Chaunchoy/NovaTech/others/3D Printed Parts/PCB_Base_Plate .jpg

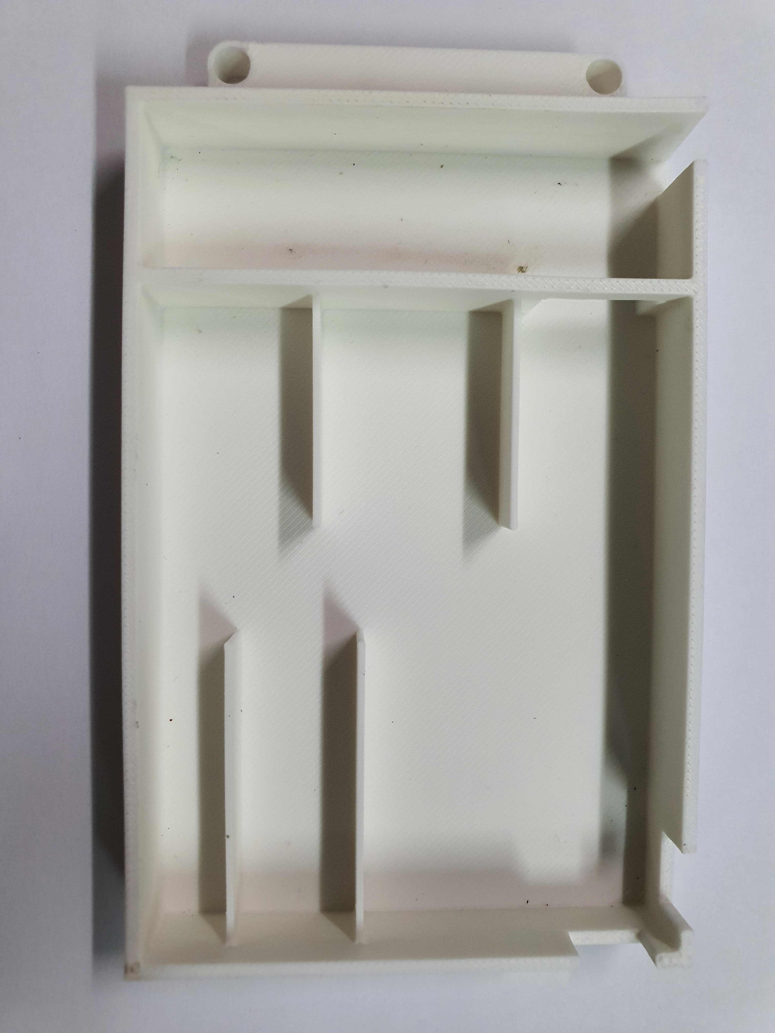
others/3D Printed Parts/PCB_Base_Plate .jpg
