Chaunchoy/NovaTech/others/3D Printed Parts/MG310_Adapter.jpg

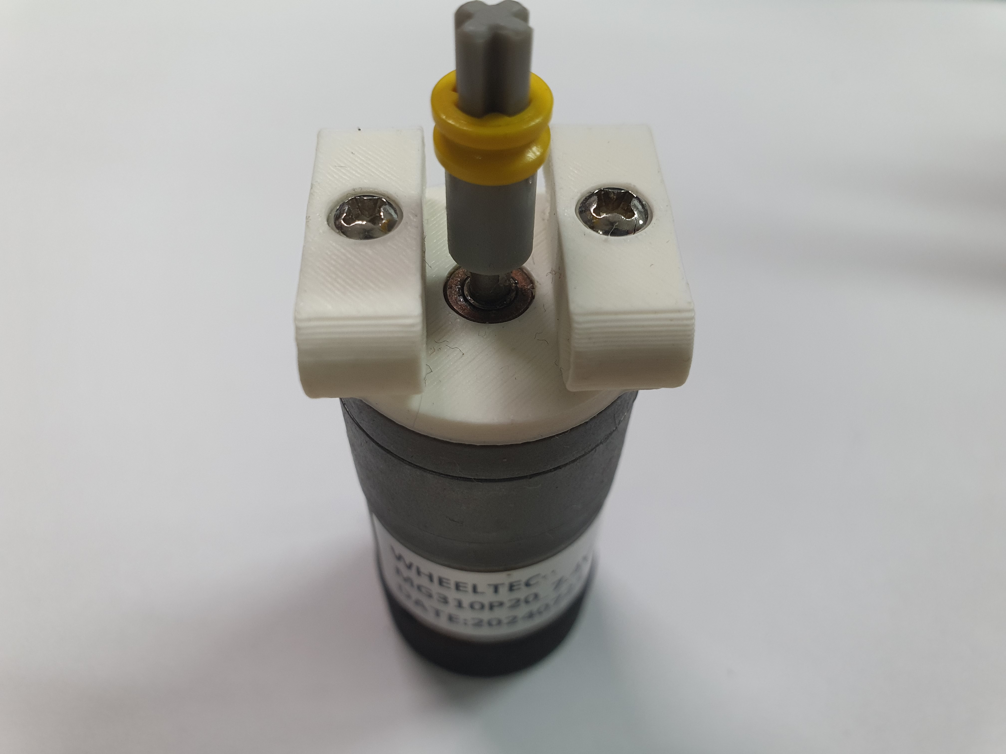
others/3D Printed Parts/MG310_Adapter.jpg
