Chaunchoy/NovaTech/others/README.md

# Others
This directory contains all photos of the components used for the vehicle:

* `3D Printed Parts` The photos of the 3D parts used for the adaptability to vehicle.
* `Control Panel` The photos of the electrical components used for the vehicle.
* `Gear System` The photos of the gear systems which is steering and the main gear system.
* `Motors` The photos of the motor used for the movement of the vehicle.
* `Sensors` The photos of the sensors used in the vehicle.
