Chaunchoy/NovaTech/models/README.md

# Models

This directory contains all the models used for our vehicle and its insturctions to build the vehicle. Since our robot is made out of LEGO technic pieces, we are going to be 3d printing mounts and adapters for the sensors. 
* `BOM_NovaTech` The record of all the components, materials and parts used in the construction of the self-driving car.
* `Building_Instructions_NovaTech` The building instructions for the self driving car.
* `LLD_MODEL_FEC_2025_vers_2` List of all the components, materials and parts used in Microsoft Excel

Below is a table of our 3D-printed parts and what they are used for:

| File Name | Description | Image | 
| --- | --- | --- |
| MG310 Lego Adapter.stl | Provides a strong and secure joint between LEGO® cross-axles/holes and MG310P20 7.4V L motor, making hybrid builds more easy to attach. |  |
| PCB Base Plate.stl | Acts as the main structural plate where components such as main panels , sensors and motors can be fixed in a place. It also strong yet thin, providing a stable chassis without adding too much weight. |  |
| TCS Adapter.stl | It acts as a connector between LEGO® Technic parts and non-LEGO® components (TCS3472 Colour Sensor) |  |
| VL5130.stl | Holds the VL53 sensor breakout board firmly without stress on the pins. They also works as case shields for the VL53LOX ToF Sensors from shocks or misalignment. |  |
