Chaunchoy/NovaTech/video/NovaTech Documentation Video.pdf

Scan the QR Code to see our team documentation video:

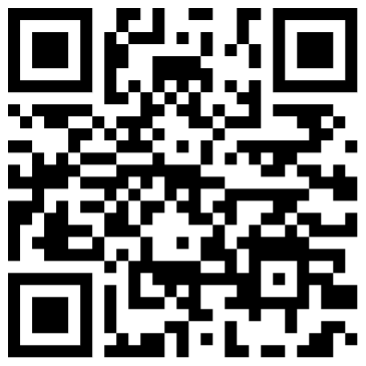
[picture p3: figure]
