Chaunchoy/NovaTech/others/Control Panel/ESP32-S3-DevKitC-1.jpg

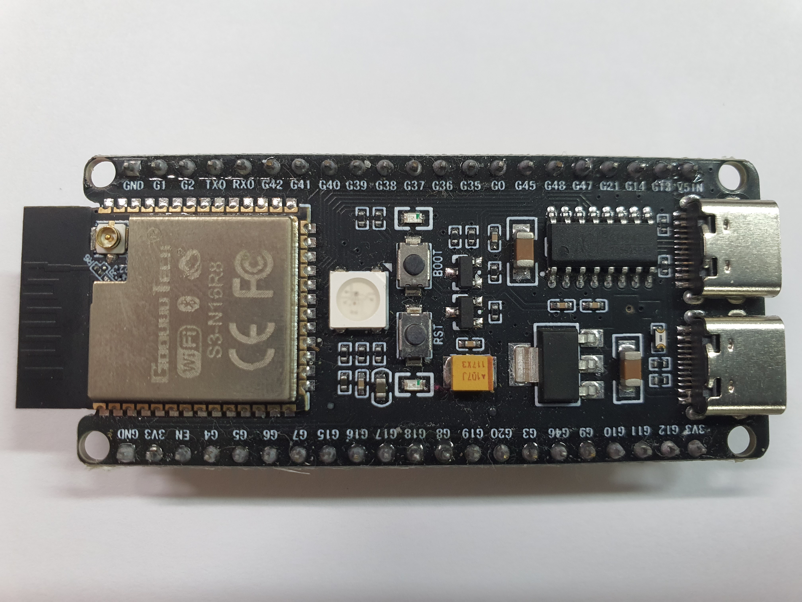
others/Control Panel/ESP32-S3-DevKitC-1.jpg
