Chaunchoy/NovaTech/others/Control Panel/GY-BNO08X Gyro.jpg

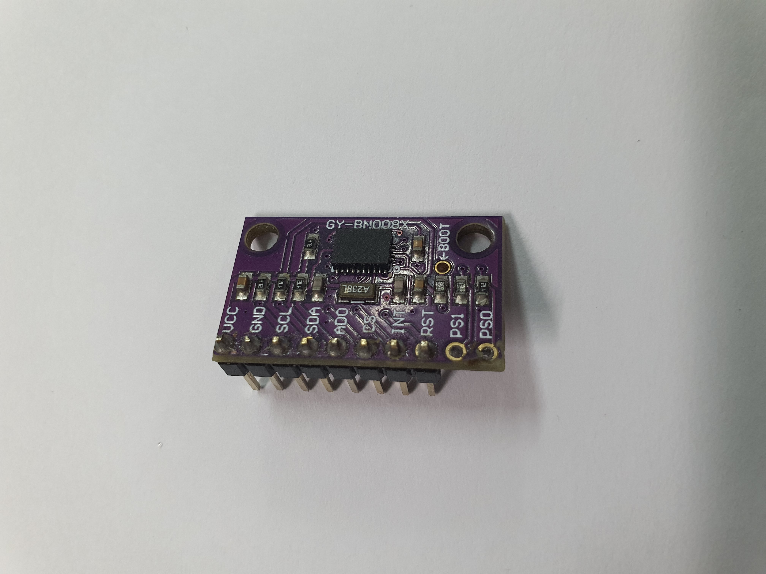
others/Control Panel/GY-BNO08X Gyro.jpg
