Chaunchoy/NovaTech/others/Control Panel/MH-FMD Active Buzzer.jpg

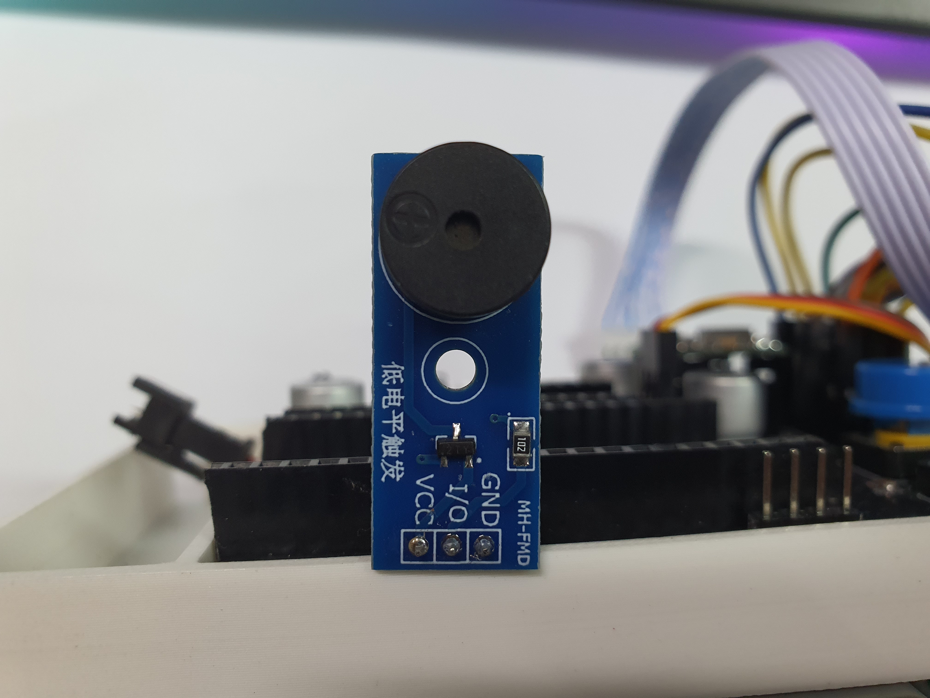
others/Control Panel/MH-FMD Active Buzzer.jpg
