Chaunchoy/NovaTech/others/Control Panel/Mini MP1584EN DC-DC Buck Converter.jpg

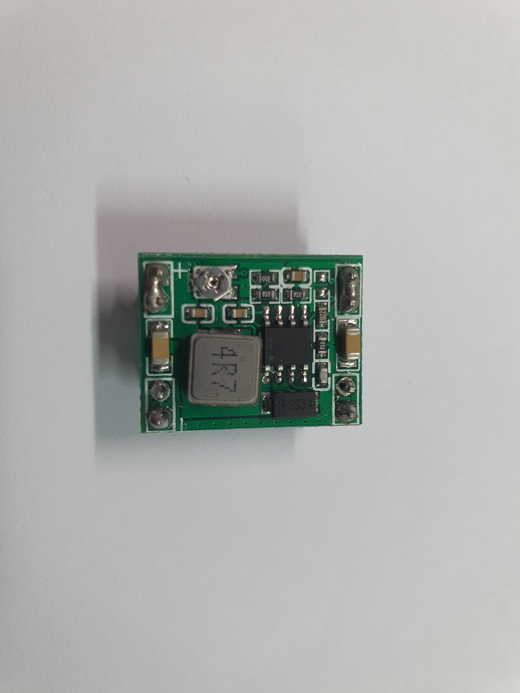
others/Control Panel/Mini MP1584EN DC-DC Buck Converter.jpg
