Chaunchoy/NovaTech/others/Control Panel/PCB Mounted Circuit Button.jpg

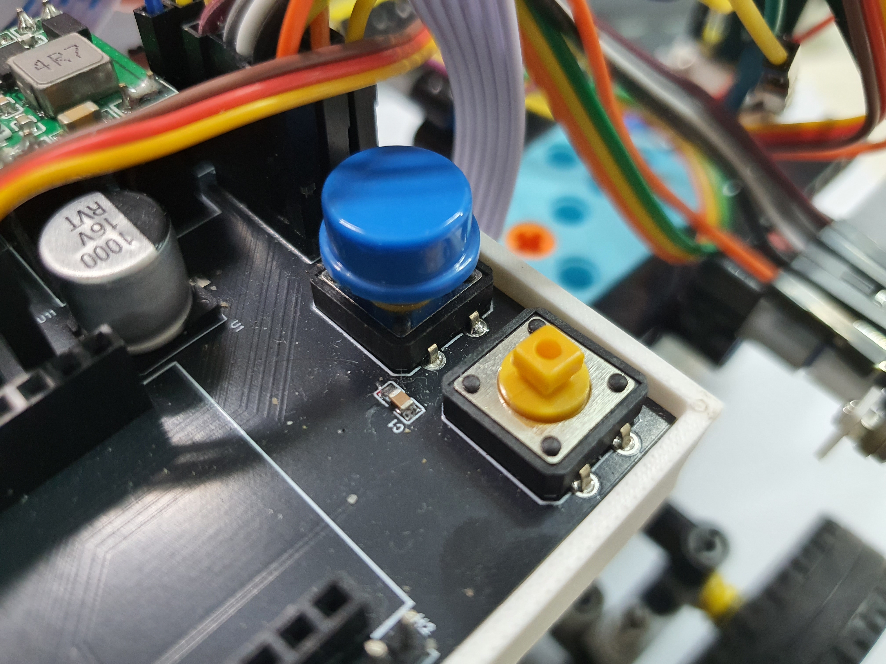
others/Control Panel/PCB Mounted Circuit Button.jpg
