Chaunchoy/NovaTech/others/Control Panel/Resistor.jpg

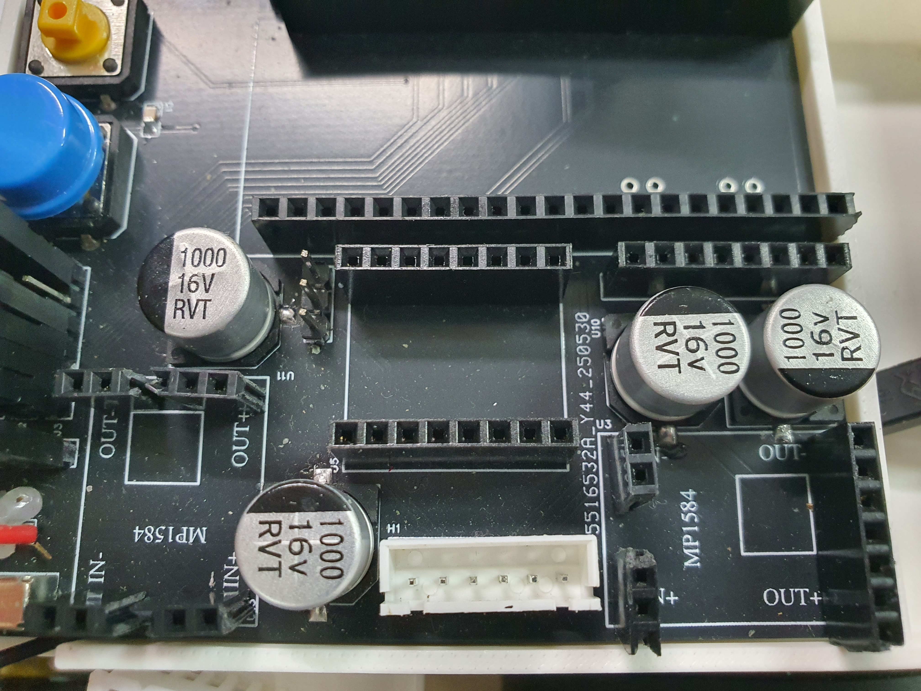
others/Control Panel/Resistor.jpg
