Chaunchoy/NovaTech/others/Gear System/AckermannSteeringSystem(Left).jpg

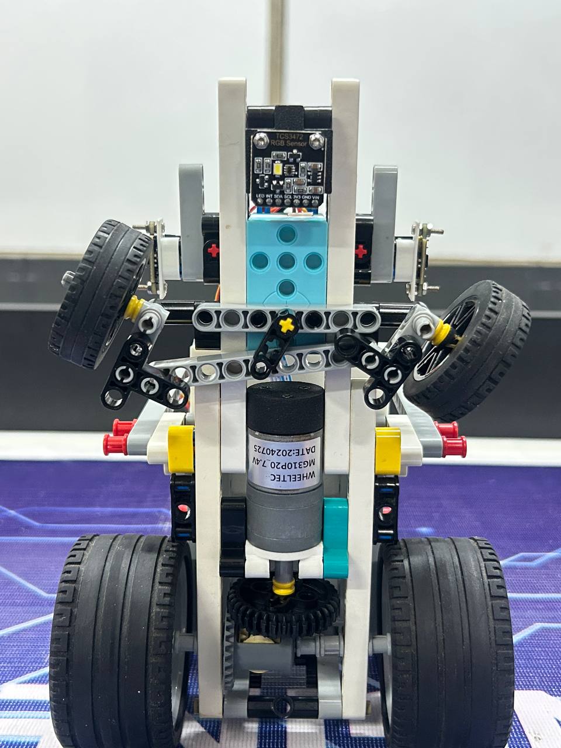
others/Gear System/AckermannSteeringSystem(Left).jpg
