Chaunchoy/NovaTech/others/Gear System/AckermannSteeringSystem(Right).jpg

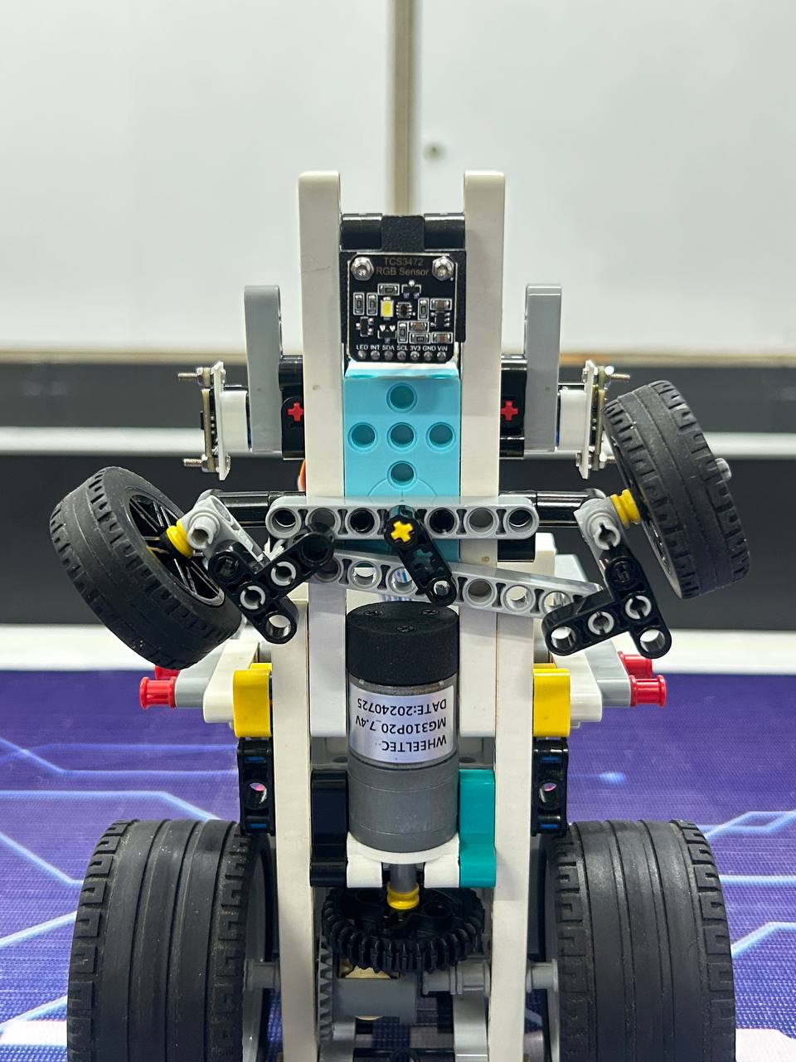
others/Gear System/AckermannSteeringSystem(Right).jpg
