Chaunchoy/NovaTech/others/Gear System/DifferentialGear.jpg

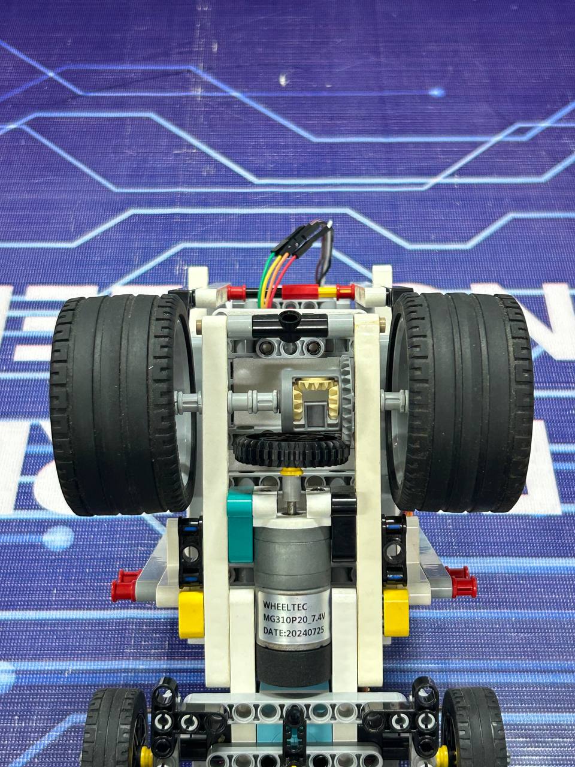
others/Gear System/DifferentialGear.jpg
