Chaunchoy/NovaTech/others/Motors/DS-E001D Micro Servo Motor (OnVehicle).jpg

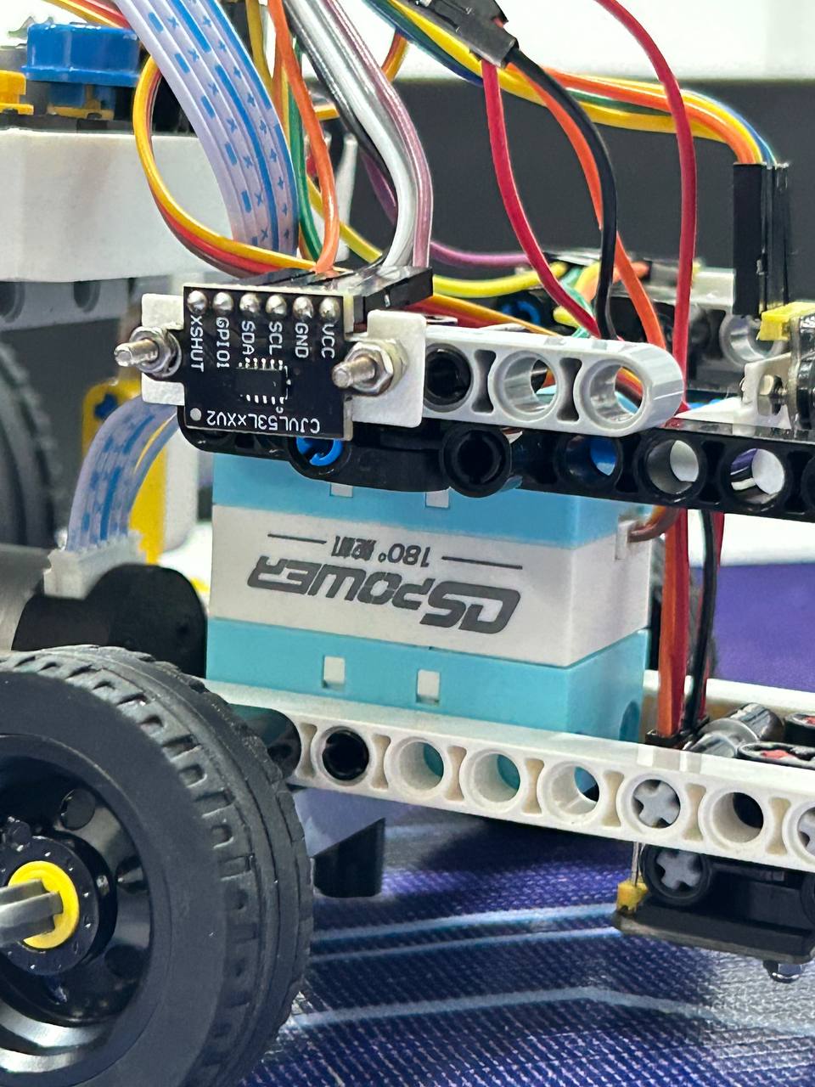
others/Motors/DS-E001D Micro Servo Motor (OnVehicle).jpg
