Chaunchoy/NovaTech/others/Motors/DS-E001D Micro Servo Motor (SideView).jpg

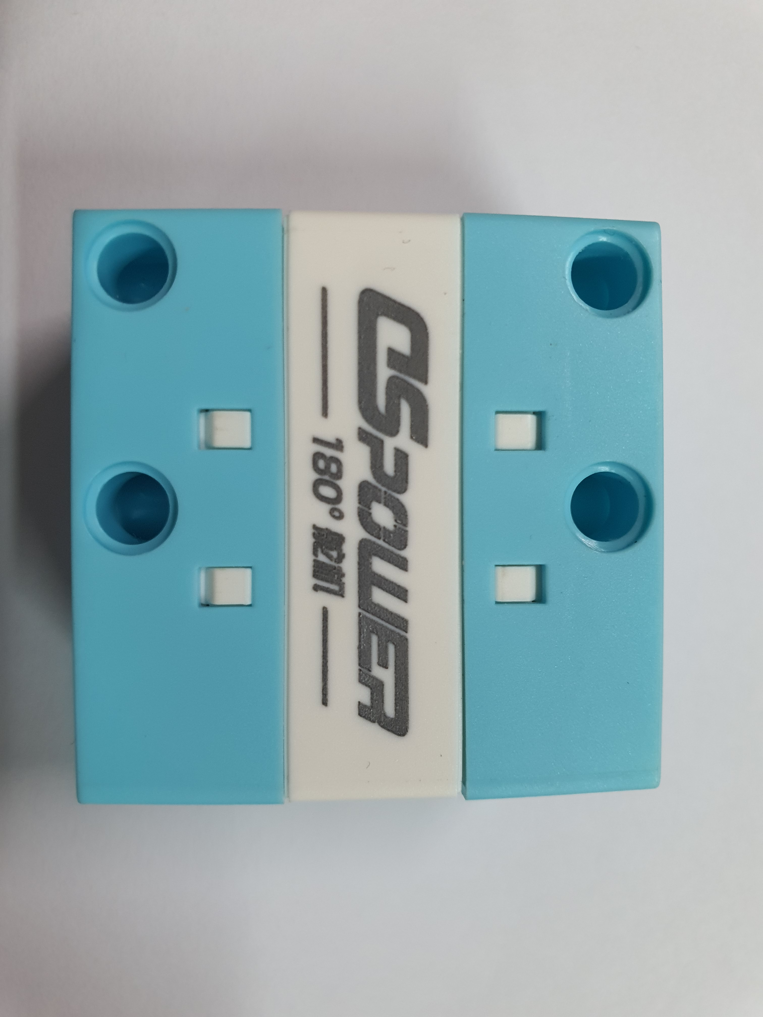
others/Motors/DS-E001D Micro Servo Motor (SideView).jpg
