Chaunchoy/NovaTech/others/Motors/DS-E001D Micro Servo Motor (TopView).jpg

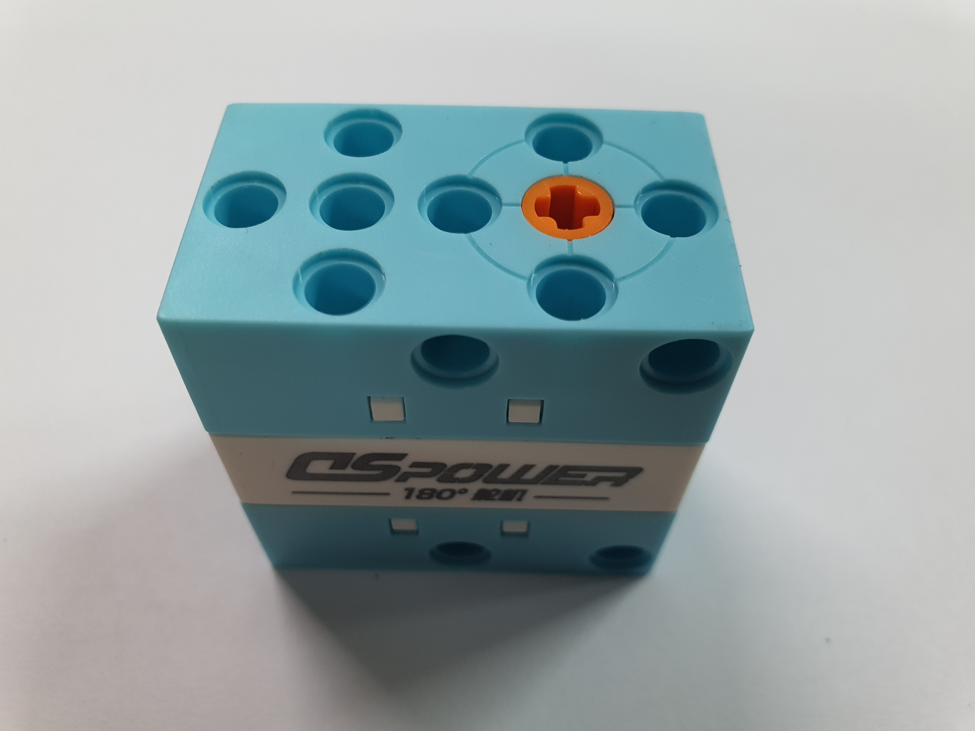
others/Motors/DS-E001D Micro Servo Motor (TopView).jpg
