Chaunchoy/NovaTech/others/Motors/WHEELTEC MG310P20 7.4V L (OnVehicle).jpg

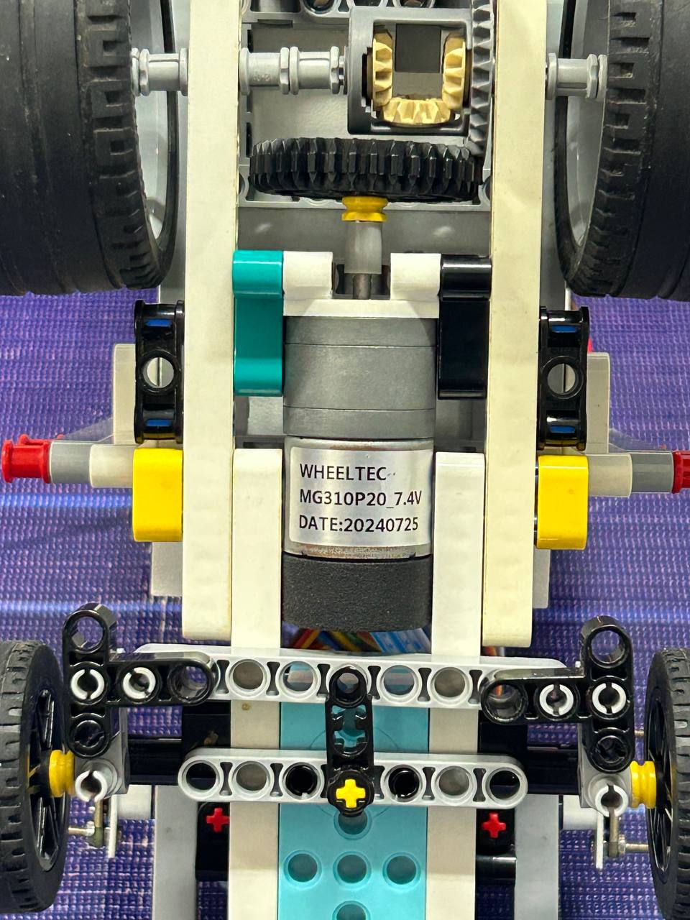
others/Motors/WHEELTEC MG310P20 7.4V L (OnVehicle).jpg
