Chaunchoy/NovaTech/others/Motors/WHEELTEC MG310P20 7.4V L (SideView).jpg

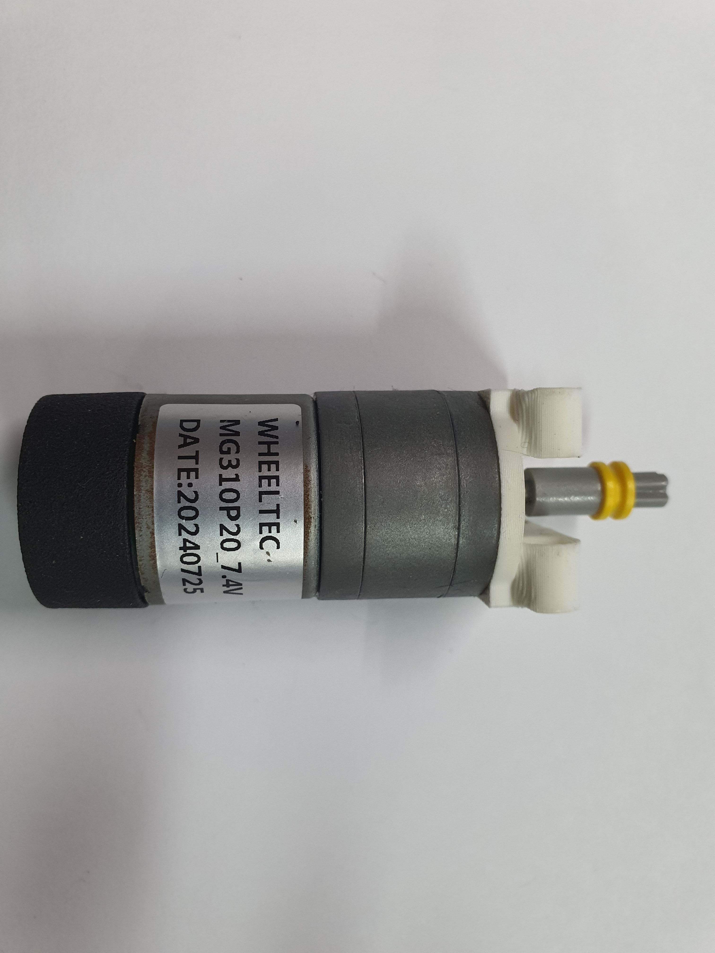
others/Motors/WHEELTEC MG310P20 7.4V L (SideView).jpg
