Chaunchoy/NovaTech/others/Sensors/Pixy2 Camera (Back).jpg

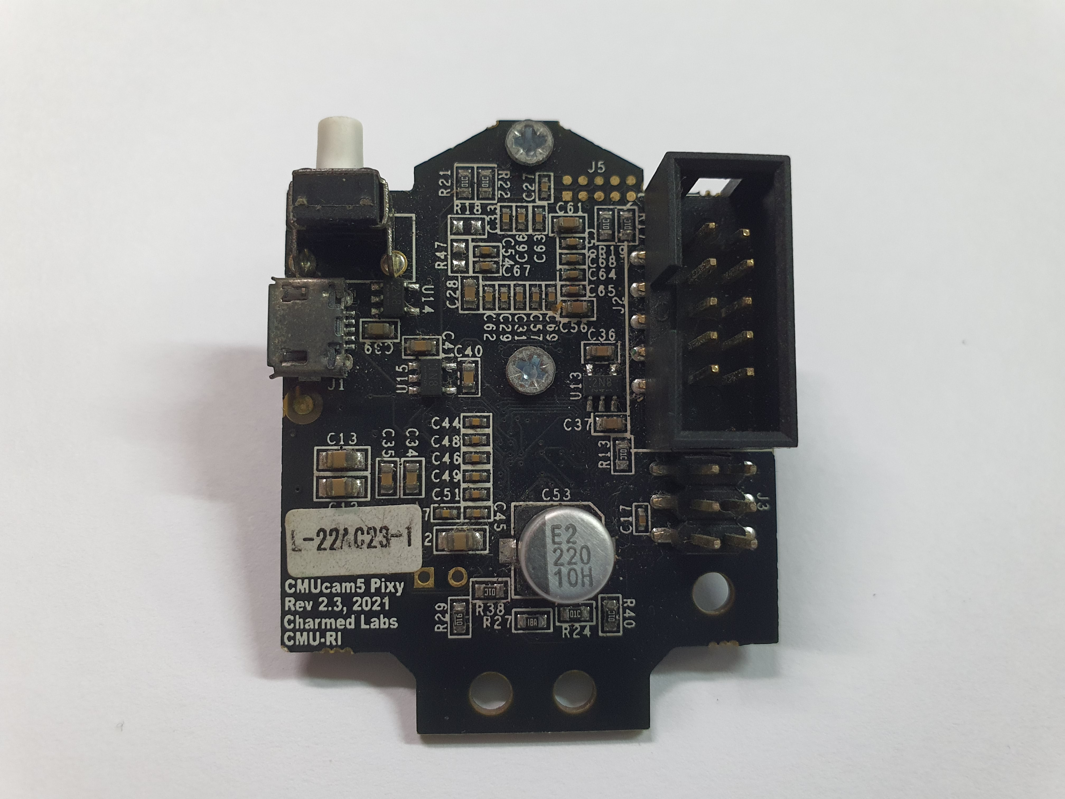
others/Sensors/Pixy2 Camera (Back).jpg
