Chaunchoy/NovaTech/others/Sensors/Pixy2 Camera (Front).jpg

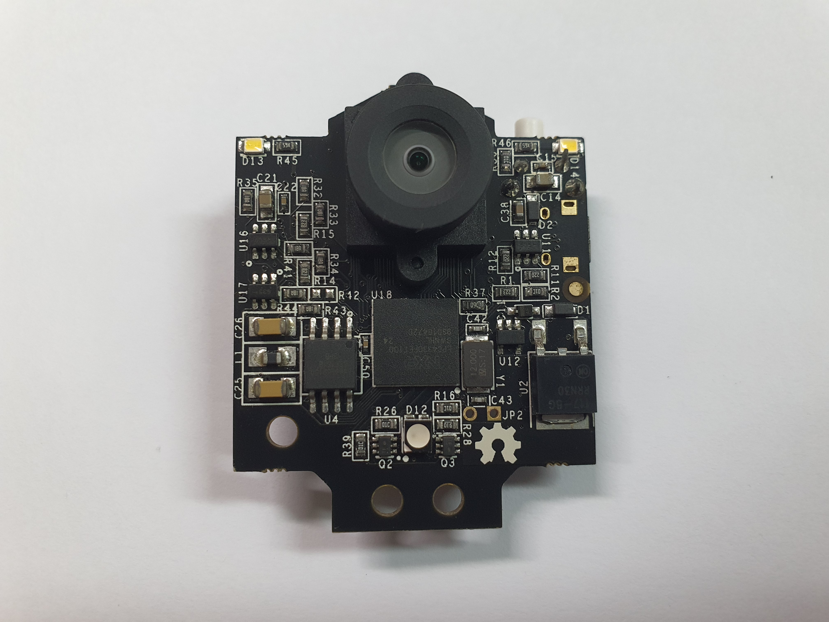
others/Sensors/Pixy2 Camera (Front).jpg
