Chaunchoy/NovaTech/others/Sensors/TCS3472 RGB Color Sensor.jpg

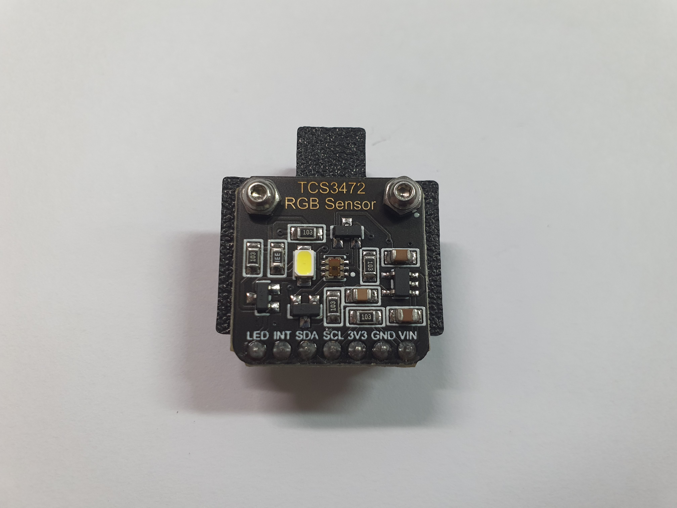
others/Sensors/TCS3472 RGB Color Sensor.jpg
