Chaunchoy/NovaTech/others/Sensors/VL53L0X Time-of-Flight Sensor.jpg

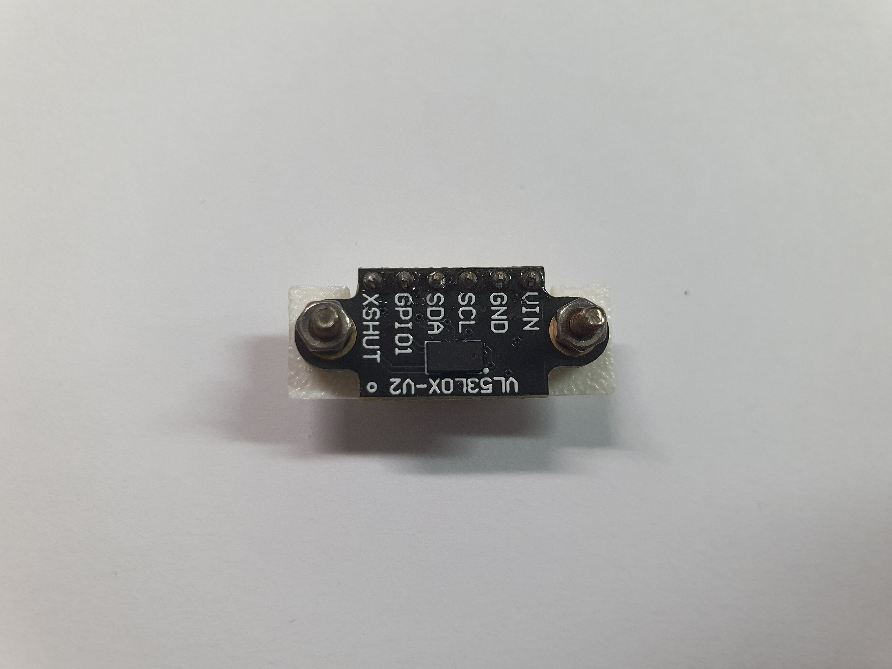
others/Sensors/VL53L0X Time-of-Flight Sensor.jpg
