Chaunchoy/NovaTech/schemes/breadboard.jpg

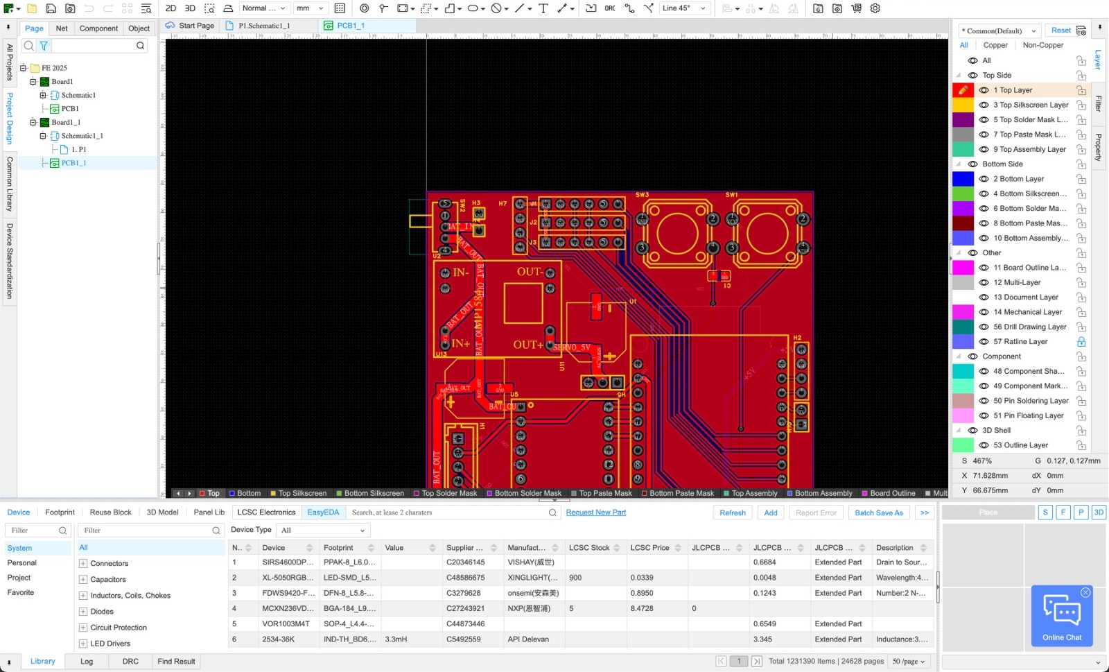
schemes/breadboard.jpg
