Chaunchoy/NovaTech/t-photos/pic-1.jpg

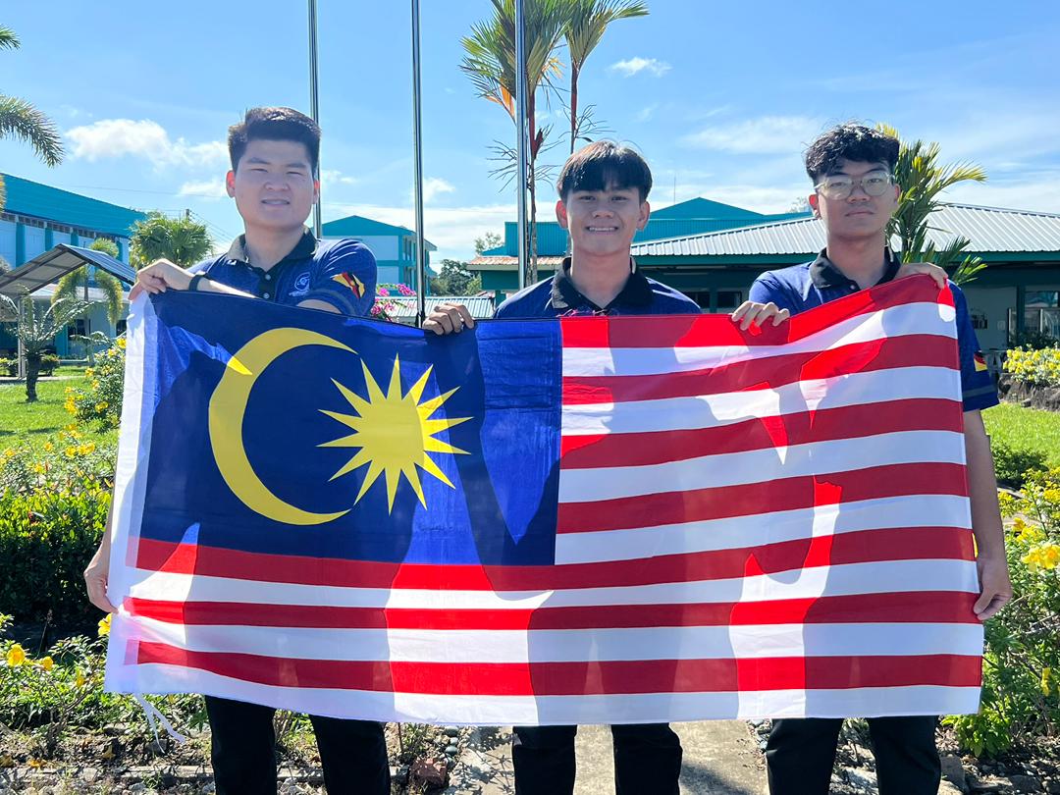
t-photos/pic-1.jpg
