Chaunchoy/NovaTech/t-photos/pic-2.jpg

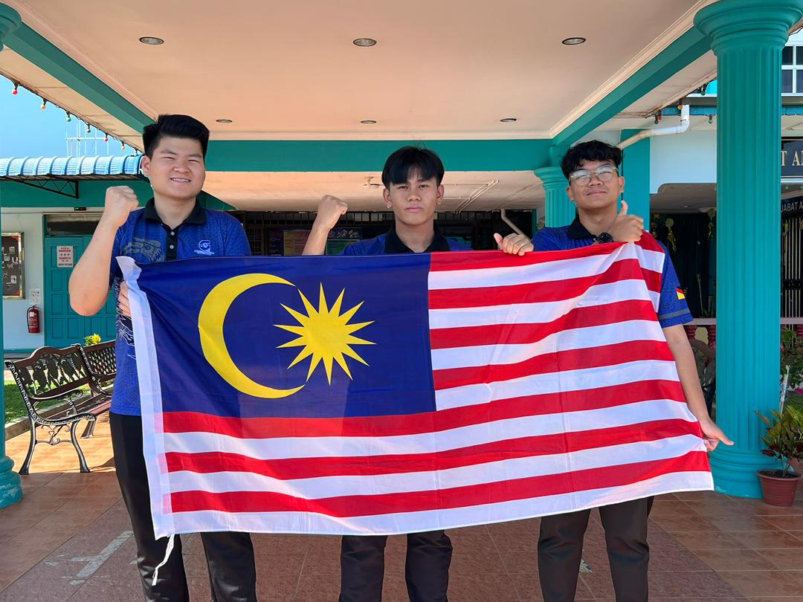
t-photos/pic-2.jpg
