Chaunchoy/NovaTech/t-photos/pic-3.jpg

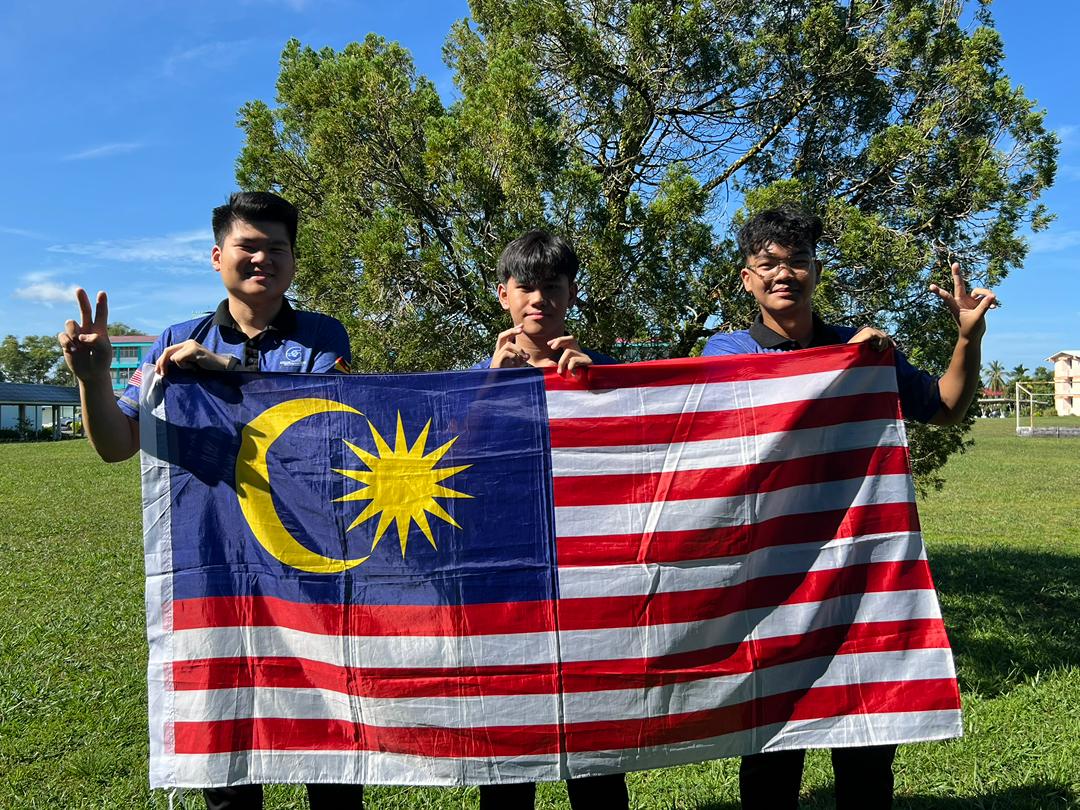
t-photos/pic-3.jpg
