Chaunchoy/NovaTech/v-photos/BottomView.jpg

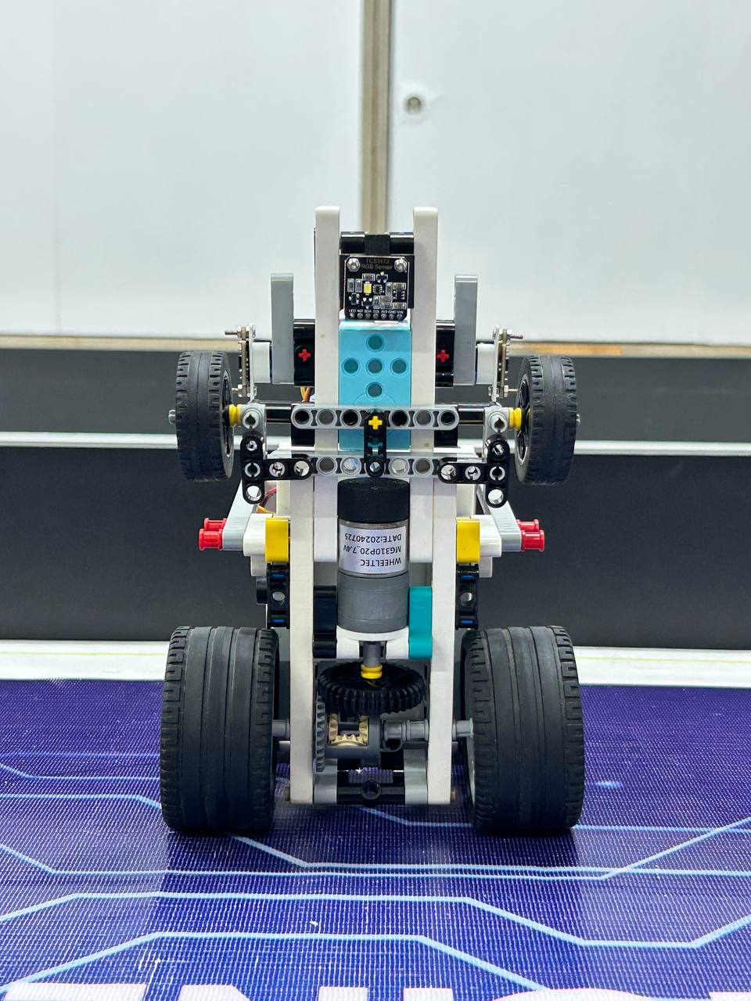
v-photos/BottomView.jpg
