Chaunchoy/NovaTech/v-photos/FrontView.jpg

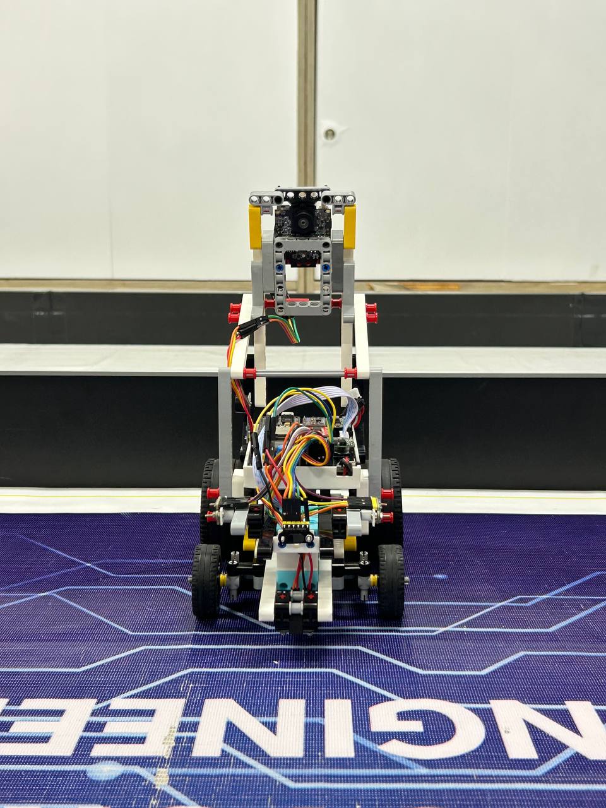
v-photos/FrontView.jpg
