Chaunchoy/NovaTech/v-photos/LeftSideView.jpg

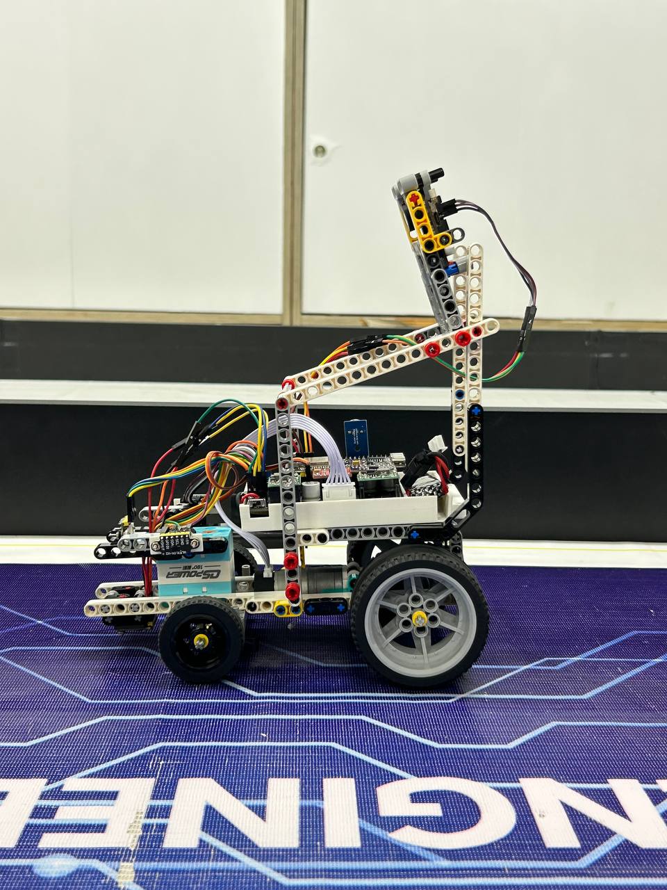
v-photos/LeftSideView.jpg
