Chaunchoy/NovaTech/v-photos/RearView.jpg

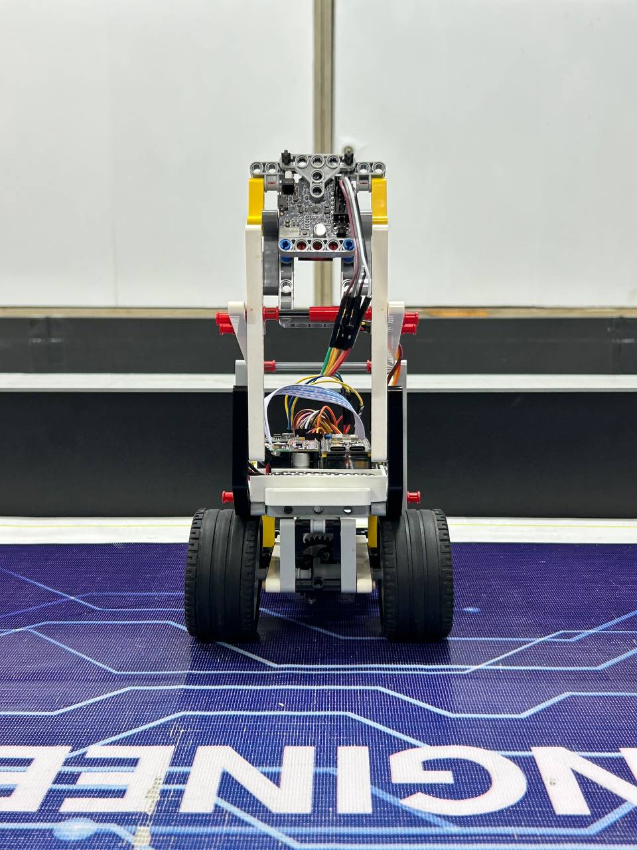
v-photos/RearView.jpg
