Chaunchoy/NovaTech/v-photos/RightSideView.jpg

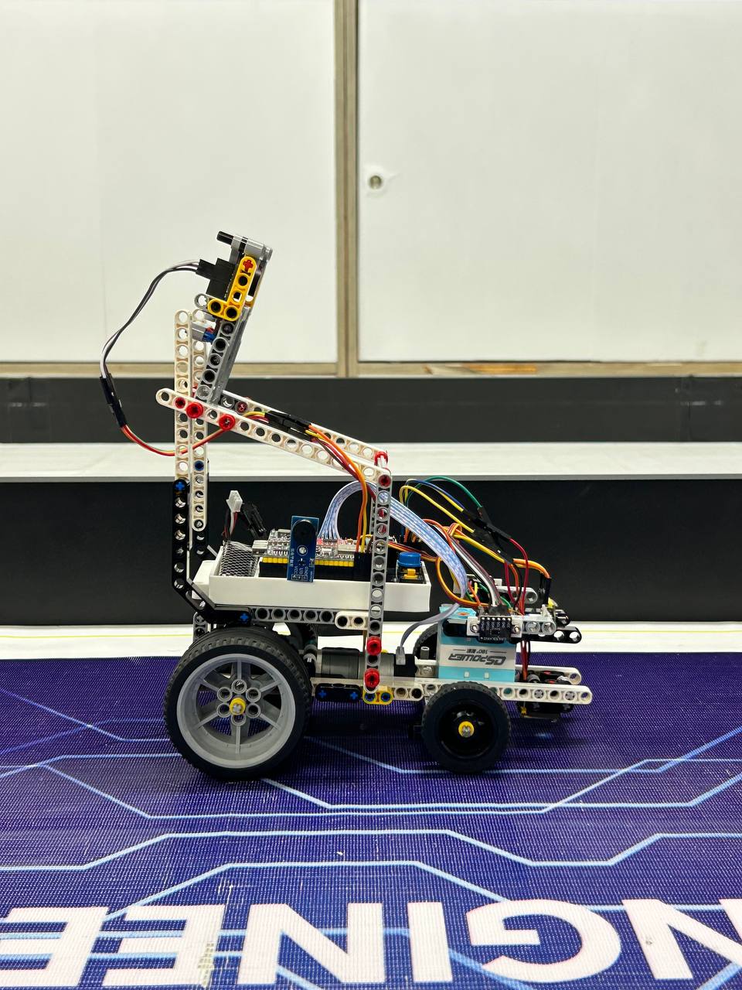
v-photos/RightSideView.jpg
