Chaunchoy/NovaTech/v-photos/TopView.jpg

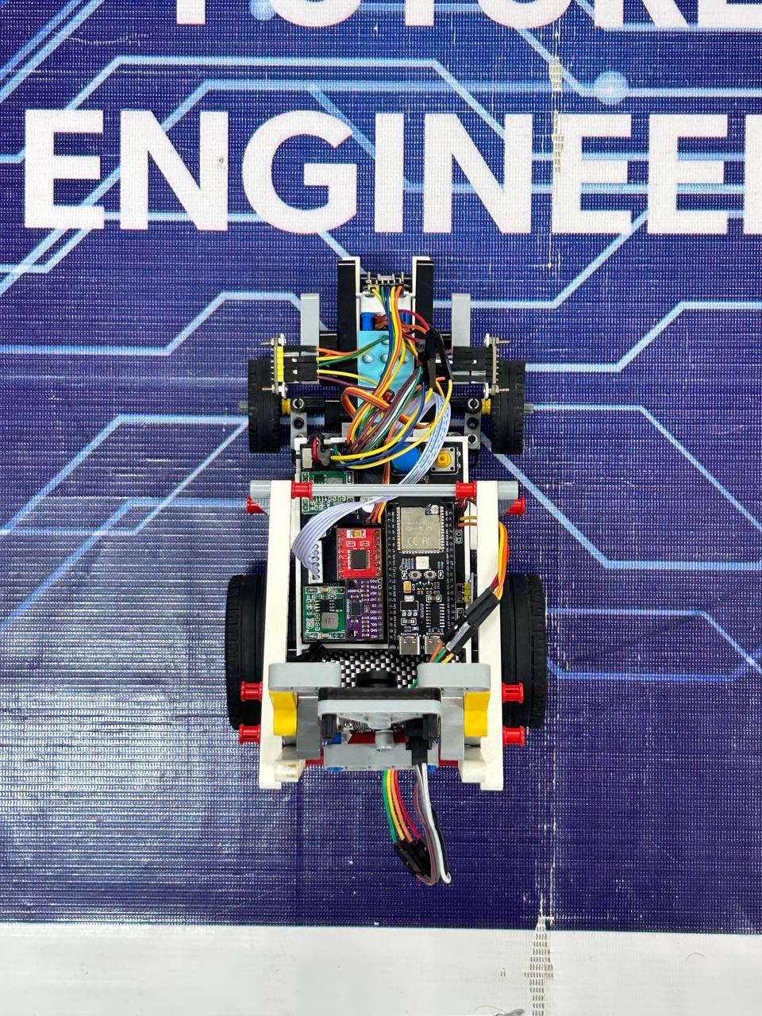
v-photos/TopView.jpg
