Chaunchoy/NovaTech/models/LDD_MODEL_FEC_2025_vers_2.xlsx

Brick | Name | Picture | Part | Color code | Quantity
 | RIM WIDE W.CROSS 30x20 |  | 56145 | 26 - Black | 2
 | TYRE NORMAL WIDE Ø43,2 X 22 |  | 44309 | 26 - Black | 2
 | RIM Ø 56 X 34 |  | 15038 | 194 - Medium Stone Grey | 2
 | TYRE LOW WIDE Ø68,8 X 36 |  | 44771 | 26 - Black | 2
 | TECHNIC 5M BEAM |  | 32316 | 194 - Medium Stone Grey | 3
 | TECHNIC 5M BEAM |  | 32316 | 199 - Dark Stone Grey | 2
 | TECHNIC 7M BEAM |  | 32524 | 194 - Medium Stone Grey | 1
 | TECHNIC ANG. BEAM 4X2 90 DEG |  | 32140 | 24 - Bright Yellow | 4
 | TECHNIC 9M BEAM |  | 40490 | 26 - Black | 2
 | TECHNIC 9M BEAM |  | 40490 | 194 - Medium Stone Grey | 1
 | T-BEAM 3X3 W/HOLE Ø4.8 |  | 60484 | 26 - Black | 4
 | TECHNIC 11M BEAM |  | 32525 | 194 - Medium Stone Grey | 2
 | TECHNIC 13M BEAM |  | 41239 | 194 - Medium Stone Grey | 2
 | TECHNIC 15M BEAM |  | 32278 | 1 - White | 8
 | TECHNIC ANG. BEAM 3X5 90 DEG. |  | 32526 | 1 - White | 2
 | TECHNIC ANG. BEAM 3X5 90 DEG. |  | 32526 | 194 - Medium Stone Grey | 2
 | TECHNIC ANG. BEAM 3X5 90 DEG. |  | 32526 | 199 - Dark Stone Grey | 2
 | DOUBLE ANGULAR BEAM 3X7 45° |  | 32009 | 26 - Black | 2
 | LEVER 5M |  | 11478 | 26 - Black | 1
 | TRIANGEL |  | 99773 | 194 - Medium Stone Grey | 1
 | 1/2 BUSH |  | 32123 | 24 - Bright Yellow | 6
 | 2M CROSS AXLE W. GROOVE |  | 32062 | 21 - Bright Red | 6
 | CONNECTOR PEG W. FRICTION |  | 2780 | 26 - Black | 46
 | CONNECTOR PEG |  | 3673 | 194 - Medium Stone Grey | 2
 | CROSS AXLE 3M |  | 4519 | 24 - Bright Yellow | 1
 | CROSS AXLE 3M |  | 4519 | 194 - Medium Stone Grey | 1
 | CONNECTOR PEG/CROSS AXLE |  | 6562 | 23 - Bright Blue | 6
 | BUSH FOR CROSS AXLE |  | 6590 | 194 - Medium Stone Grey | 7
 | CONN.BUSH W.FRIC./CROSSALE |  | 43093 | 23 - Bright Blue | 4
 | CROSS AXLE 4M |  | 3705 | 26 - Black | 1
 | CONNECTOR PEG W. FRICTION 3M |  | 6558 | 23 - Bright Blue | 12
 | Cross axle 2m w. snap w. fric. |  | 18651 | 26 - Black | 4
 | CROSS AXLE, EXTENSION, 2M |  | 59443 | 21 - Bright Red | 1
 | CROSSAXLE 3M WITH KNOB |  | 6587 | 138 - Sand Yellow | 2
 | CROSS AXLE 5M |  | 32073 | 194 - Medium Stone Grey | 3
 | ANGLE ELEMENT, 0 DEGREES [1] |  | 32013 | 26 - Black | 2
 | BEAM 1X2 W/CROSS AND HOLE |  | 60483 | 26 - Black | 2
 | CROSS AXLE 4M WITH END STOP |  | 87083 | 199 - Dark Stone Grey | 2
 | 2M FRIC. SNAP W/CROSS HOLE |  | 32054 | 21 - Bright Red | 12
 | CROSS AXLE 7M |  | 44294 | 194 - Medium Stone Grey | 1
 | DOUBLE CROSS BLOCK |  | 32184 | 26 - Black | 2
 | ANGLE ELEMENT, 180 DEGREES [2] |  | 32034 | 26 - Black | 1
 | CROSS AXLE 9M |  | 60485 | 194 - Medium Stone Grey | 2
 | TECHNIC CROSS BLOCK 2X1 |  | 32291 | 26 - Black | 4
 | TECHNIC CROSS BLOCK/FORK 2X2 |  | 41678 | 26 - Black | 4
 | 2X1X3 STEERING KNUCKLE ARM |  | 33299 | 26 - Black | 3
 | CROSS BLOCK 3X2 |  | 63869 | 194 - Medium Stone Grey | 3
 | BEAM 3 M. W/4 SNAPS |  | 48989 | 194 - Medium Stone Grey | 2
 | BEAM FRAME 5X7 Ø 4.85 |  | 64179 | 194 - Medium Stone Grey | 3
 | CONICAL WHEEL Z12 |  | 6589 | 5 - Brick Yellow | 3
 | DIFFERENTIALE 3M Z 28 |  | 62821 | 199 - Dark Stone Grey | 1
Total: |  |  |  |  | 196
