Chaunchoy/NovaTech/others/3D Printed Parts/TCS_Adapter.jpg

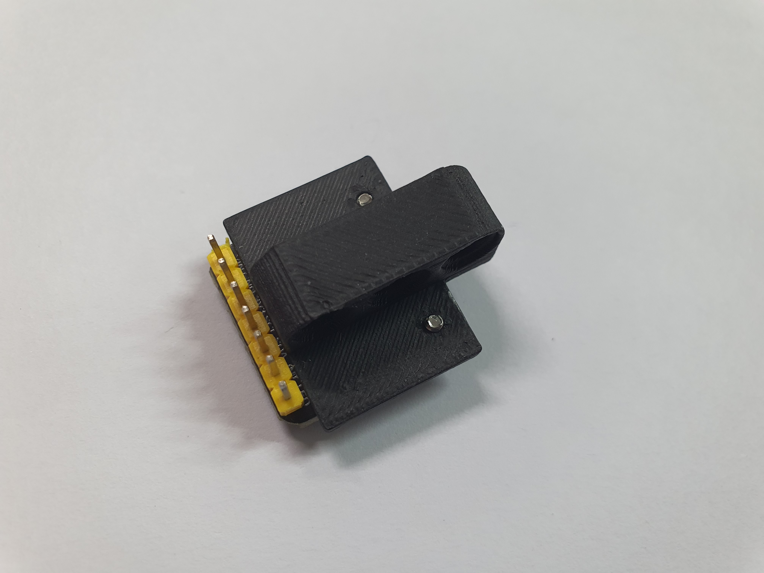
others/3D Printed Parts/TCS_Adapter.jpg
