Chaunchoy/NovaTech/others/3D Printed Parts/VL5130_Adapter.jpg

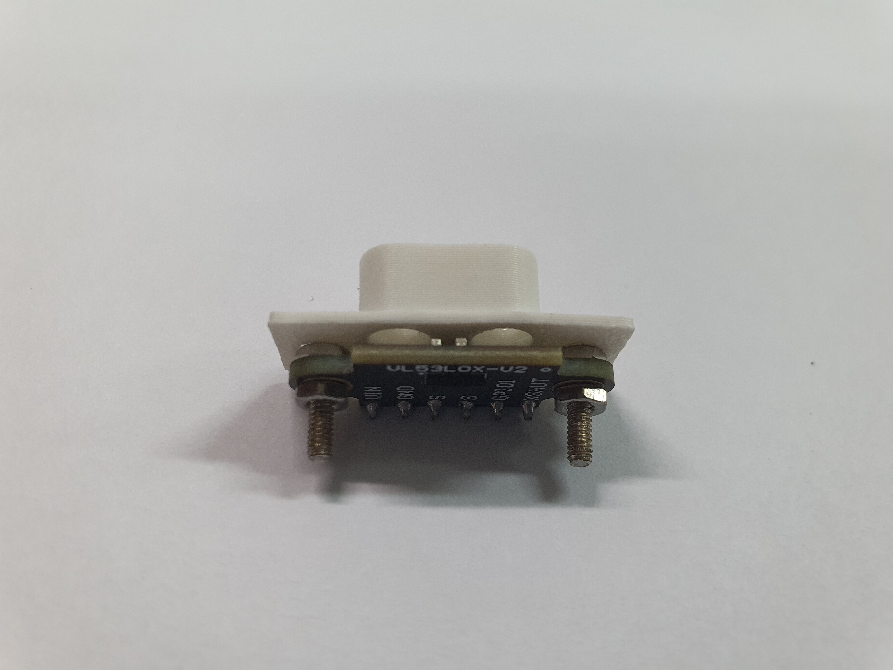
others/3D Printed Parts/VL5130_Adapter.jpg
