Chaunchoy/NovaTech/models/Building Instructions for 3D-Printed Parts/PCB Base Plate.stl

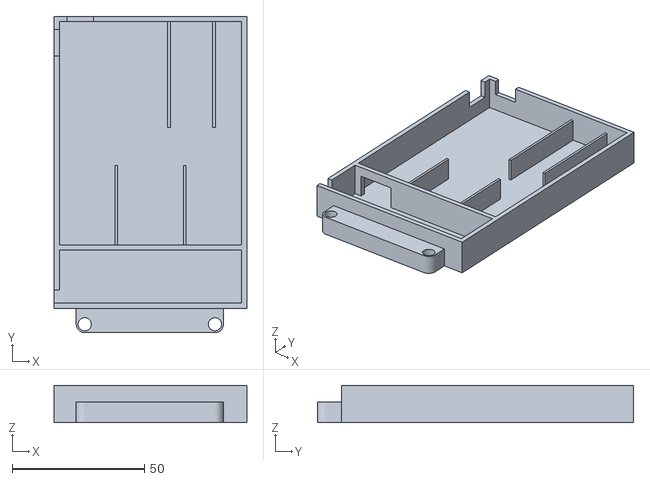
[picture p34: CAD file, 2025-08-23]
models/Building Instructions for 3D-Printed Parts/PCB Base Plate.stl
73.0 x 119.7 x 14.0
