Chaunchoy/NovaTech/models/Building Instructions for 3D-Printed Parts/MG310 Lego Adapter.stl

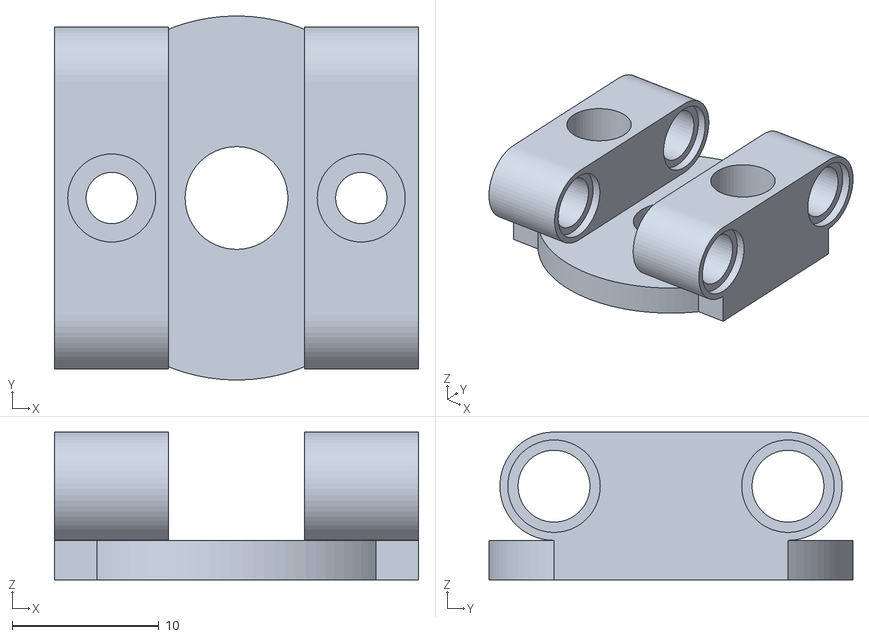
[picture p35: CAD file, 2025-08-23]
models/Building Instructions for 3D-Printed Parts/MG310 Lego Adapter.stl
24.8 x 24.8 x 10.1
