Chaunchoy/NovaTech/models/Building Instructions for 3D-Printed Parts/TCS Adapter.stl

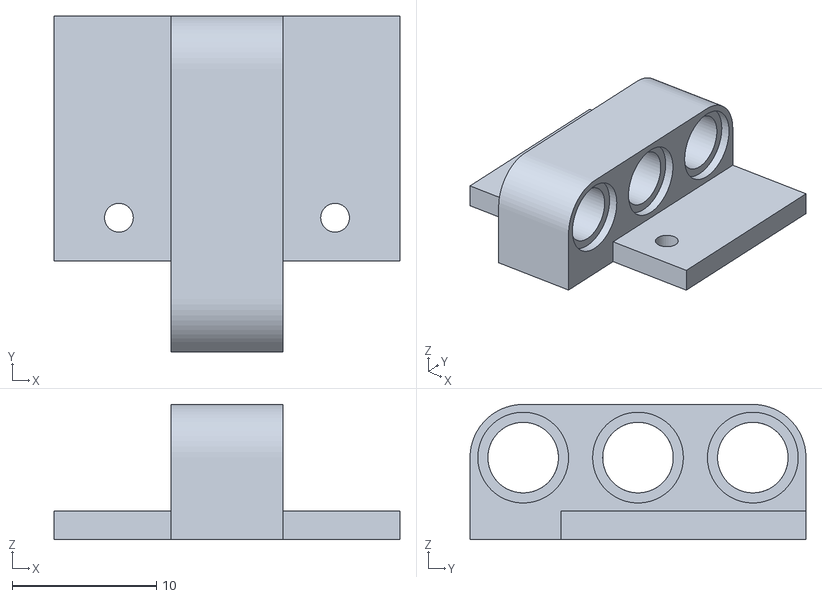
[picture p36: CAD file, 2025-08-23]
models/Building Instructions for 3D-Printed Parts/TCS Adapter.stl
24.0 x 23.3 x 9.38
