Chaunchoy/NovaTech/models/Building Instructions for 3D-Printed Parts/VL5130.stl

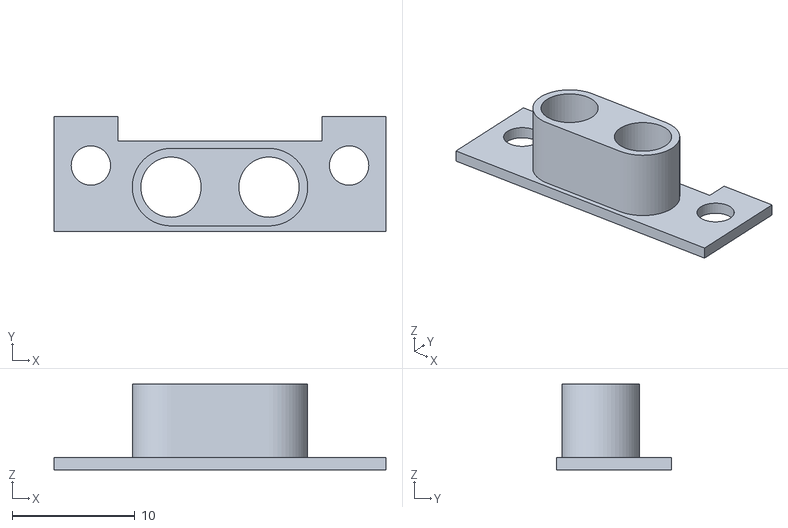
[picture p37: CAD file, 2025-08-23]
models/Building Instructions for 3D-Printed Parts/VL5130.stl
27.0 x 9.38 x 6.96
