Chaunchoy/NovaTech/models/Building Instructions for 3D-Printed Parts/VL6180.stl

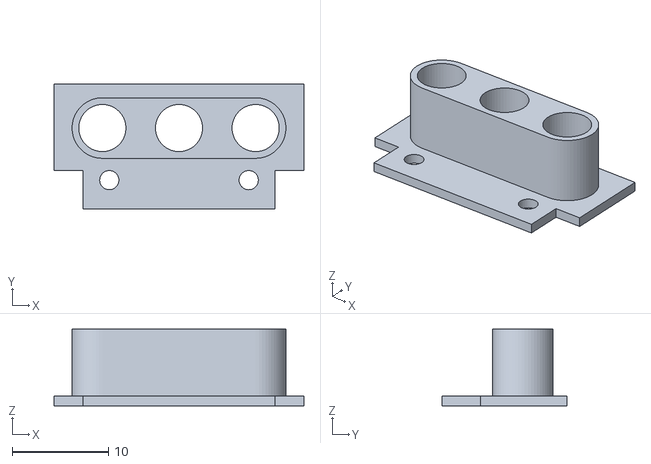
[picture p38: CAD file, 2025-08-23]
models/Building Instructions for 3D-Printed Parts/VL6180.stl
26.0 x 13.0 x 7.96
