Chaunchoy/NovaTech/schemes/wiring_schematic_diagram.jpg

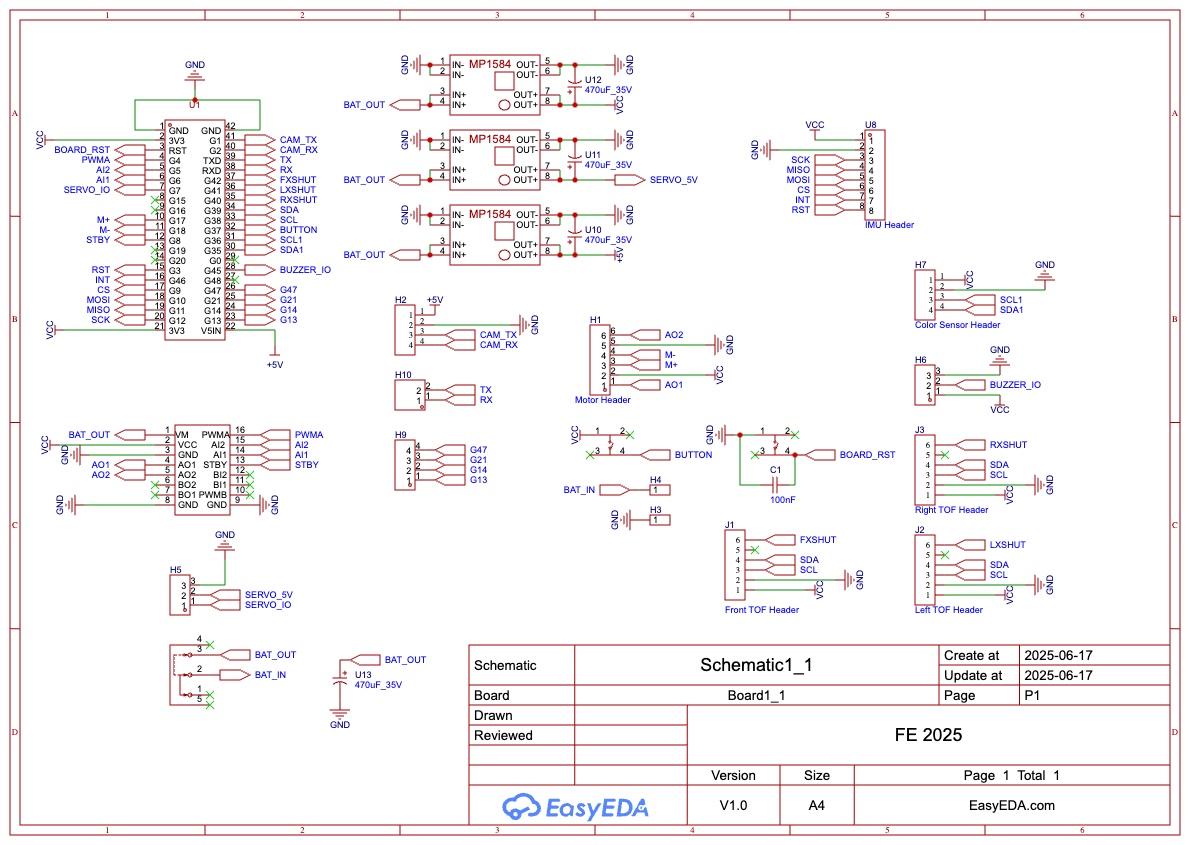
schemes/wiring_schematic_diagram.jpg
