Chaunchoy/NovaTech/src/Open Challenge Flow Chart .pdf

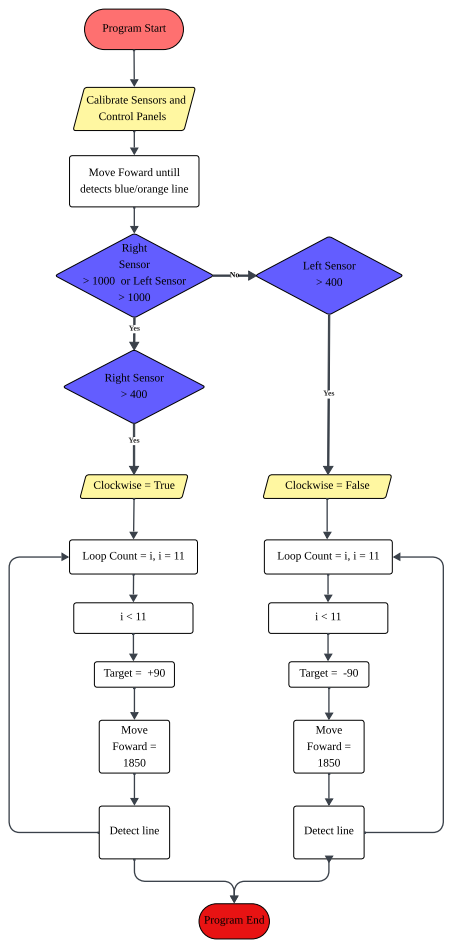
[picture p40: page 1]
Program Start; CalibrateSensorsand Control Panels; Right Sensor > 1000 or Left Sensor > 1000; Yes; Right Sensor > 400; Clockwise= True; Clockwise= False; Left Sensor > 400; Loop Count = i, i = 11; Target = +90; Program End; Move Foward = 1850; Detect line; Target = -90

MoveFoward untill
detects blue/orangeline
