Chaunchoy/NovaTech/src/Obstacle Challenge Flow Chart.pdf

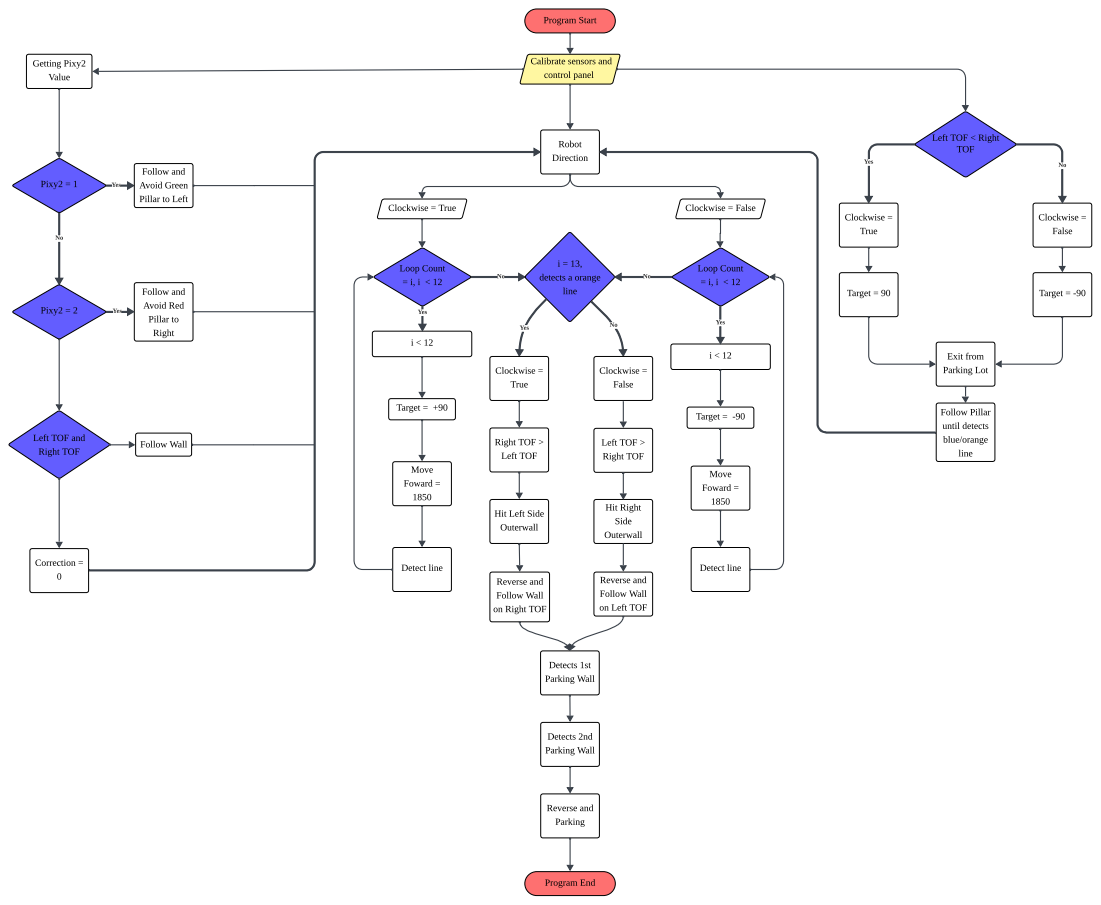
[picture p41: page 1]
Program Start; Calibratesensors and control panel; Getting Pixy2 Value; Pixy2 = 1; Yes; Pixy2 = 2; Follow and Avoid Red Pillar to Right; Exit from Parking Lot; Follow Pillar until detects blue/orange line; Clockwise= True; Clockwise= False; Follow Wall; Correction = 0; Target = 90; Target = -90; Robot Direction; Loop Count = i, i < 12; Target = +90; Move Foward = 1850; Detect line; i = 13, detectsaorange line; Right TOF > Left TOF; Left TOF > Right TOF; Hit Right Side Outerwall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

Left TOF < Right
TOF

Follow and
Avoid Green
Pillar to Left

Left TOF and
Right TOF

Hit Left Side
Outerwall

Reverseand
Follow Wall
on Right TOF

on Left TOF
